joembedded/open_sensor_blue_public/documentation/0800_marder/README.md

# 0800_Marderli #
_Docu for this project_

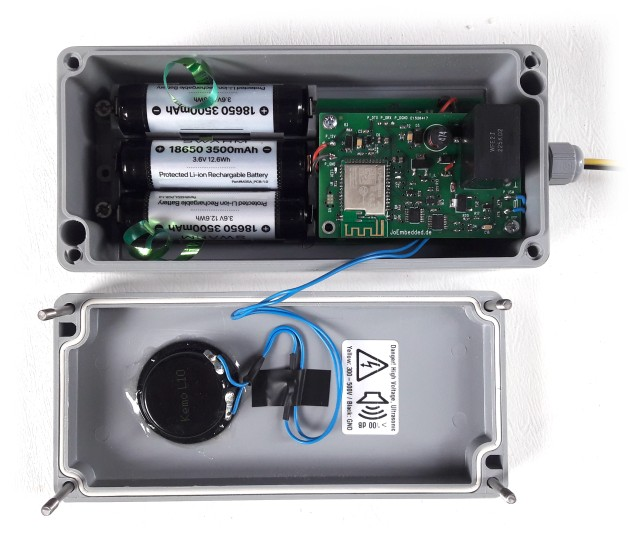
[picture p2: documentation/0800_marder/img/marderli_int.jpg]
'Marderli intern'
 <br>Marderli inside (Battery Version)

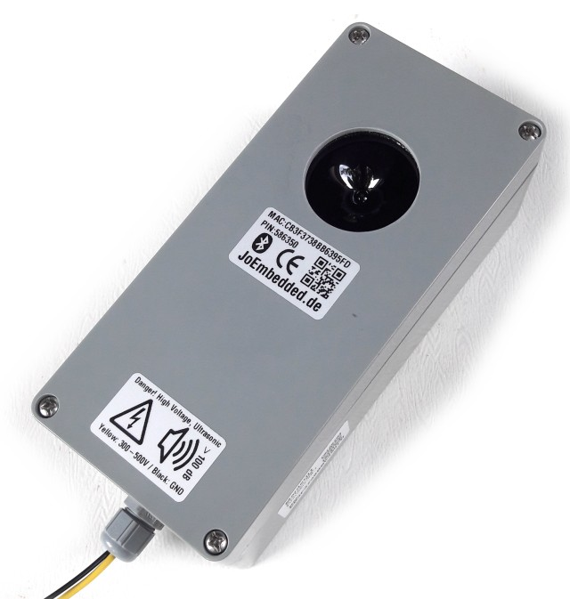
[picture p3: documentation/0800_marder/img/marderli.jpg]
'Marderli'
 <br>Marderli (Battery Version)

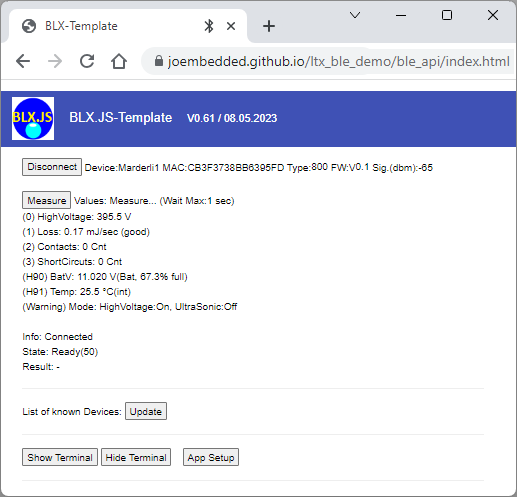
[picture p4: documentation/img_allg/blx_js.png]
Browser-APP 'BLX.JS'
 <br>Browser-APP - Repository: https://github.com/joembedded/ltx_ble_demo

- [Schematics and PCB](./cad/) Production data
- [Simulation](./simulation/) Simulation files for LTspice
- [Images](./img/) More images and measurments

---
