joembedded/open_sensor_blue_public/documentation/0800_marder/img/BLE_Basic_connected.png

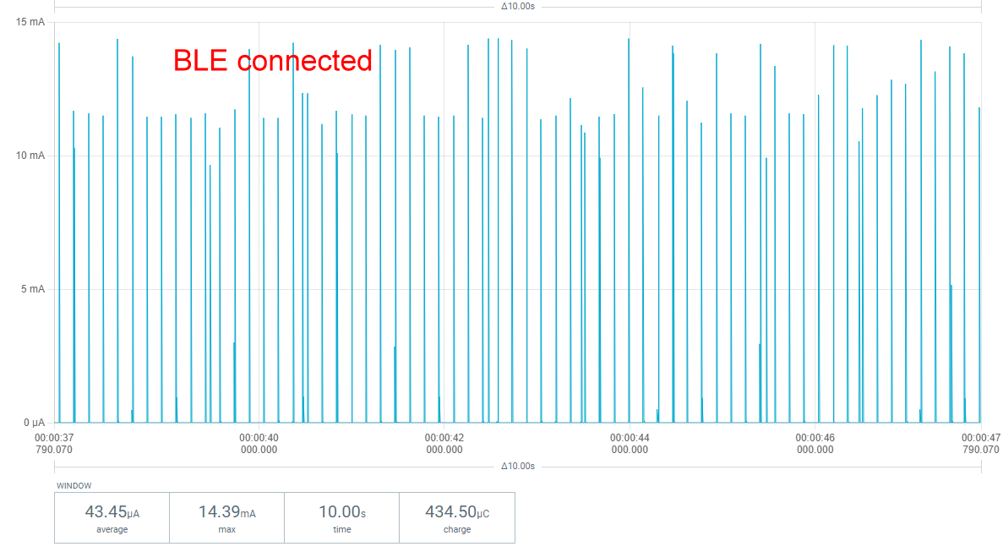
documentation/0800_marder/img/BLE_Basic_connected.png
