joembedded/open_sensor_blue_public/documentation/0800_marder/img/BLE_Basic_unconnected.png

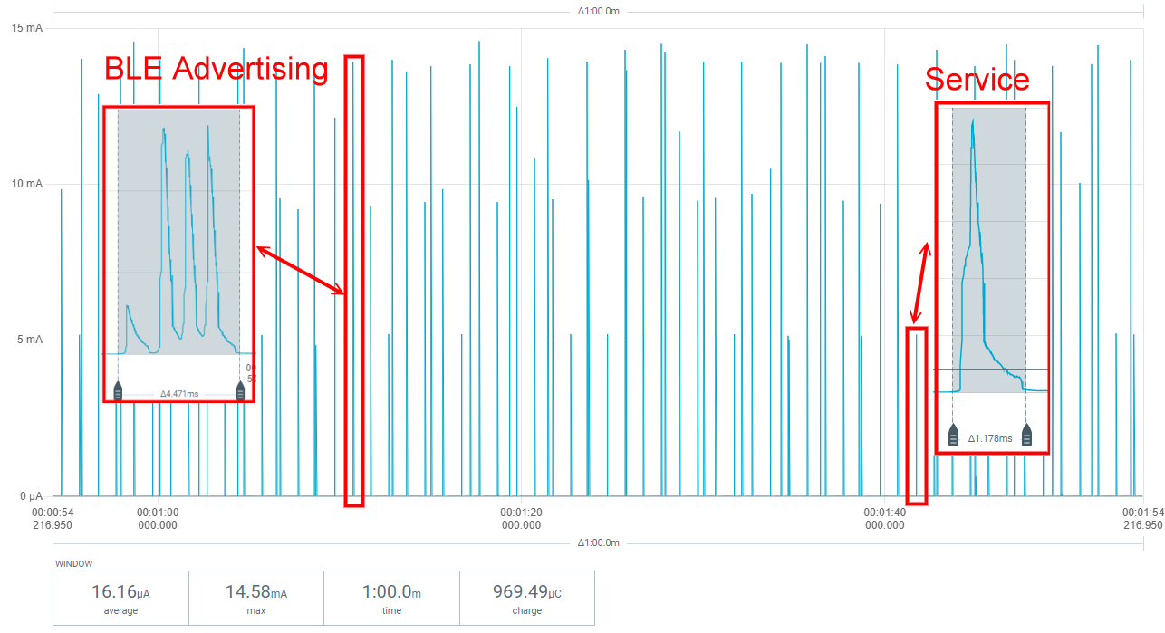
documentation/0800_marder/img/BLE_Basic_unconnected.png
