joembedded/open_sensor_blue_public/documentation/0800_marder/img/charge1k7_real.png

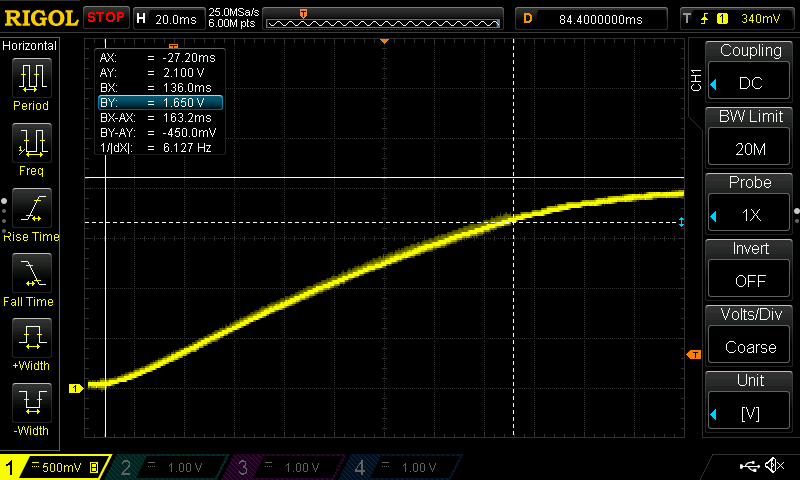
documentation/0800_marder/img/charge1k7_real.png
