joembedded/open_sensor_blue_public/documentation/0800_marder/img/fullcharge_4Ohm7_I_12v_2u2.png

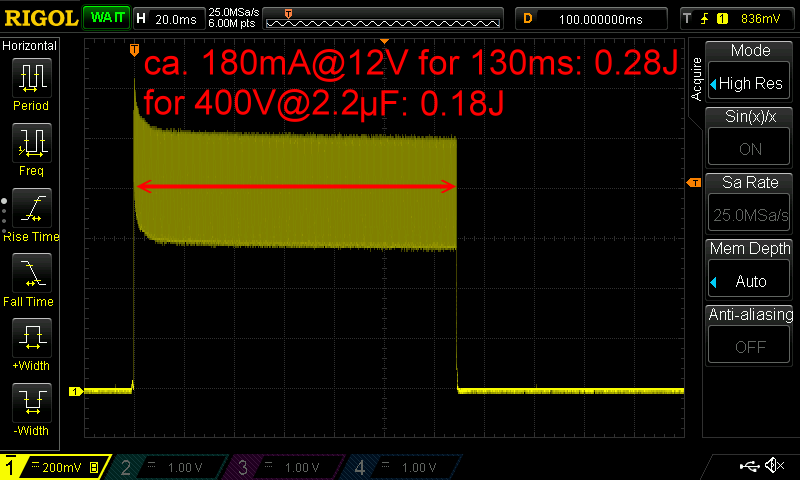
documentation/0800_marder/img/fullcharge_4Ohm7_I_12v_2u2.png
