joembedded/open_sensor_blue_public/documentation/0800_marder/img/pcb_raw.jpg

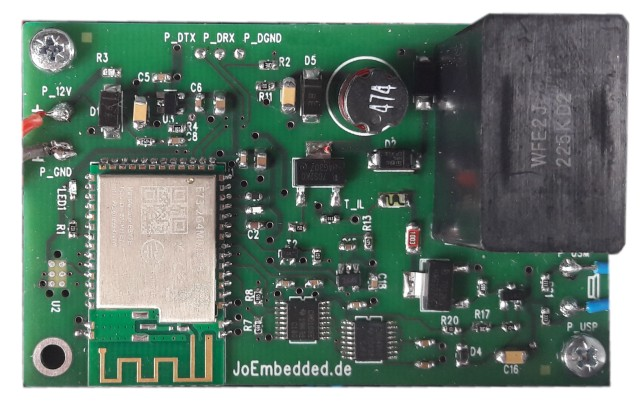
documentation/0800_marder/img/pcb_raw.jpg
