joembedded/open_sensor_blue_public/documentation/0800_marder/img/service_charge_12V_2u2_t210.png

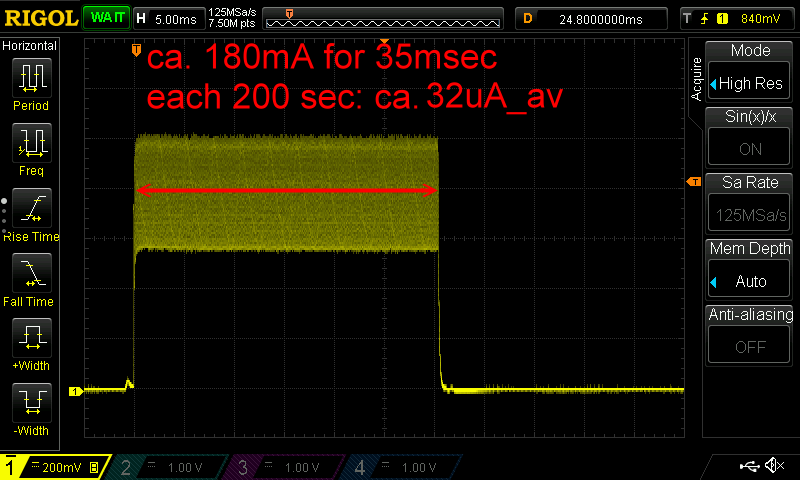
documentation/0800_marder/img/service_charge_12V_2u2_t210.png
