joembedded/open_sensor_blue_public/documentation/0800_marder/img/usonic_4Ohm7_I.png

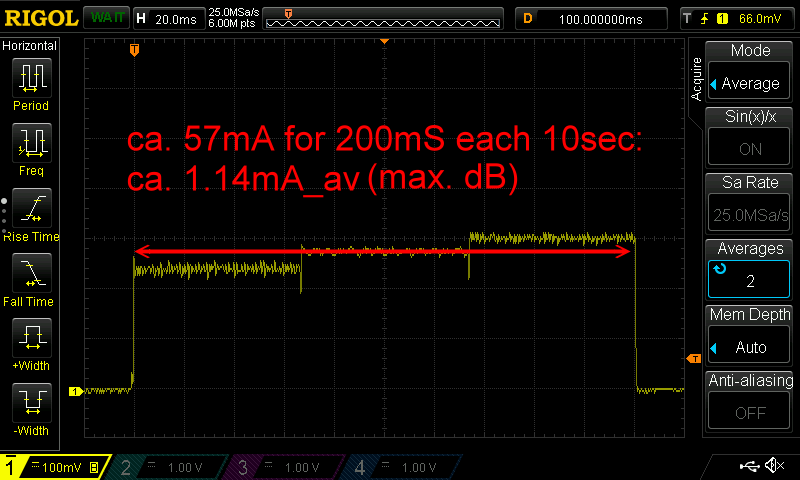
documentation/0800_marder/img/usonic_4Ohm7_I.png
