joembedded/open_sensor_blue_public/documentation/0800_marder/cad/bom_1V1.ods

*** BOM – Marder1V1 – 15.07.2023 – JoEmbedded.de ***
Qty | Reference | Part Name | VALUE | PCB DECAL | Remark | Source (FA: Farnell) | Variant
1 | U1 | E73_BLE |  | E73_BLE | LowCost BLE-Module NRF52832 | CDEBYTE (China)
1 | U3 | XC6216_MR | XC6216, XC6216B332MR oder 331(1 = 1%), 3.3V/SOT23-5 | SOT23-5 |  | FA:3106590
1 | U4 | CD4049 | Inverter/Driver | TSSOP16 |  | MOUSER:595-CD4049UBPWR
1 | U5 | CD40109 | Level-Shifter | TSSOP16 |  | FA:3120904
1 | U6 | TLV_LowIq/Ibias | Opamp TLV379, TLV9041, MCP6041, etc | SOT23-5 |  | FA:1332129 | MPC604
1 | T1,T3 | FET_N-Channel | HV_FET | SOT223-3 | HV_FET, z.B. STN6N60M2 oder IPN70R2K0P7S | FA:3155115
1 | T2 | FET_N-Channel | BSS138W | SC-70-3
1 | T4 | TRANS_UNI_PNP | BC857 | SOT23
2 | D1,D5 | DIODE_TVS | TVS12V – SMAJ12A | SMA | Achtung: nur bis max. 14V einsetzbar, siehe Doku. | FA:2429071
1 | D2 | DIODE | FAST_HV | SMA | HV.Diode Utrafast, >=600V, <=25nsec (z.B. STTH1R06(25 nsec/600V) | FA:1697520
1 | D3 | DIODE_TVS | TVS400V – SMAJ400A | SMA | Durchbruch i.d.R ca. 480V | FA:2763008
1 | D4 | DIODE | 1N4148 in 0805 | DIODE0805 | 1N4148 (SOD-523 aufloetbar auf 0805) | FA:2453270
1 | LED1 | LED_2PINS | ROT | LED0603
3 | C1,C13,C16 | Capacitor(Ceramic) | 22uF/25V | 1206
1 | C2 | Capacitor(Ceramic) | 1uF | 0603
1 | C3,C7 | Capacitor(Ceramic) | 10uF | 0805
8 | C4,C5,C6,C8,C10,C11,C12,C18 | Capacitor(Ceramic) | 100nF | 0603
2 | C9,C17 | Capacitor(Ceramic) | x00nF/25V | 0603 | z.B. fuer KEMO L010: 1uF/25V mit >= 15Ohm in Serie
1 | C14 | Capacitor(Ceramic) | 2.2-4.7uF/600V | C_RM5MMAA | Empfohlen: 2,2uF/600V | FA:2581162 | 2.2uF
1 | C15 | Capacitor(Ceramic) | 10nF | 0603
1 | R1 | Resistor | 1k | 0603
1 | R2 | Resistor | 1M | 0603
1 | R3 | Resistor | 15(*) | 0603 | Falls Vbat >14V mgl, erhoehen oder staerkere Leistung! Siehe Doku.
5 | R4,R7,R8,R16,R17 | Resistor | 1.6M_1% | 0603
2 | R5;R13 | Resistor | 4.7M_1% | 0603
2 | R6,R21 | Resistor | 33k | 0603
1 | R9 | Resistor | 10k | 0603
1 | R10 | Resistor | 15 | 0603
1 | R11 | Resistor | 10(*) | 0603 | Falls Vbat >14 mgl, erhoehen oder staerkere Leistung!
1 | R12 | Resistor | 1GOhm_HV_1% | 1206 | Unbedingt HV-Fester Typ! | FA: 3596701
1 | R14 | Resistor | 100-1k_PP | 1206 | Unbedingt HV-Fester Typ! Limit. Imax, <10k mit 1206 nicht mgl., THT verw.! (im Redesign), z.B. (KTR18, 910Ohm zu schwach)
1 | R15 | Resistor | 100k_HV | 1206 | Unbedingt HV-Fester Typ! | FA:2470926
1 | R18 | Resistor | 0.1 | 0603 | Nur wg. Development,/L3-Test kann 0 sein für Produktion
1 | R19 | Resistor | 160k | 0603
1 | R20 | Resistor | 100 | 0603
1 | L1 | INDUKT | 10uH | 0603 | (nur weil E73 kein DC/DC on Boarrd)
1 | L2 | INDUKT | 15nH | 0603 | (nur weil E73 kein DC/DC on Boarrd)
1 | L3 | INDUKT_PWR | 470uH_HV (>=600V, 1A I_Sat) | IND_RM5MM_D10MM | HV-feste Spulen meist nur in THT erhaehltlich. | Coilcraft:RFC0807BV-474KE
1 | (extern) | USONIC | Ultraschall-Piezo-Lautsprecher mind. >26kHz | KEMO L010 (z.B.) | Achtung: für den KEMO L010: C9,C17 zur Lautstärkebenzung mind. >= 15Ohm in Serie! | KEMO L010
