joembedded/open_sensor_blue_public/documentation/0800_marder/cad/marder_1v1_asstop.pdf

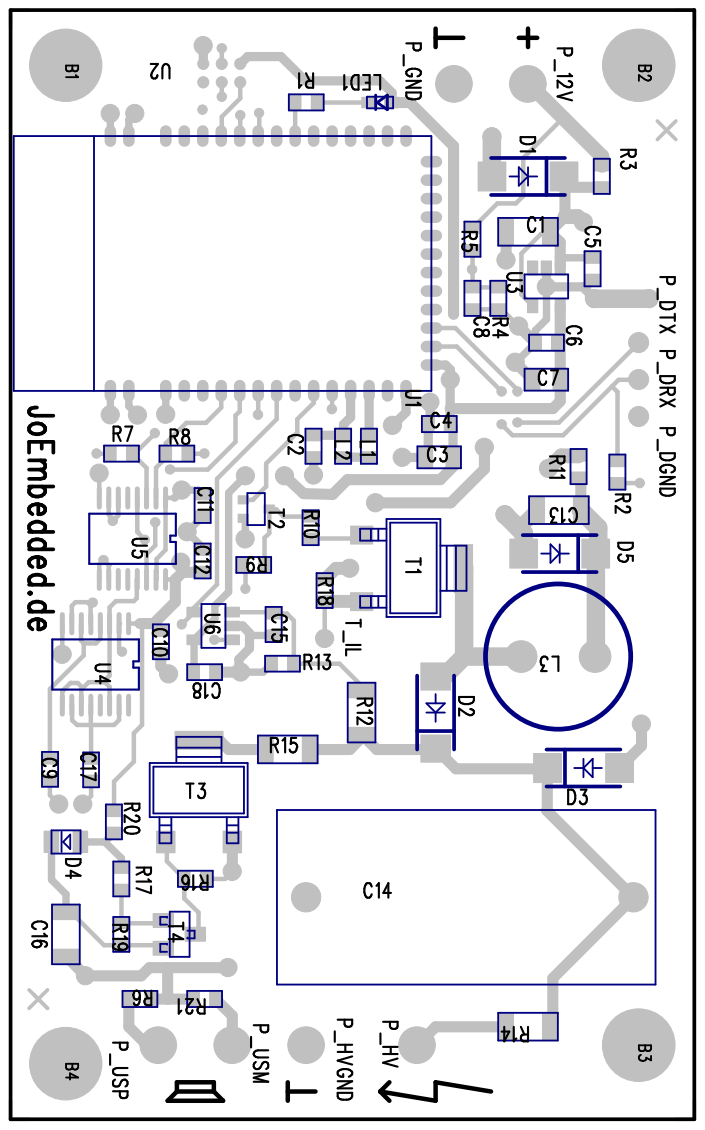
[picture p15: page 1]
