joembedded/open_sensor_blue_public/documentation/0800_marder/cad/marder_1v1_sch.pdf

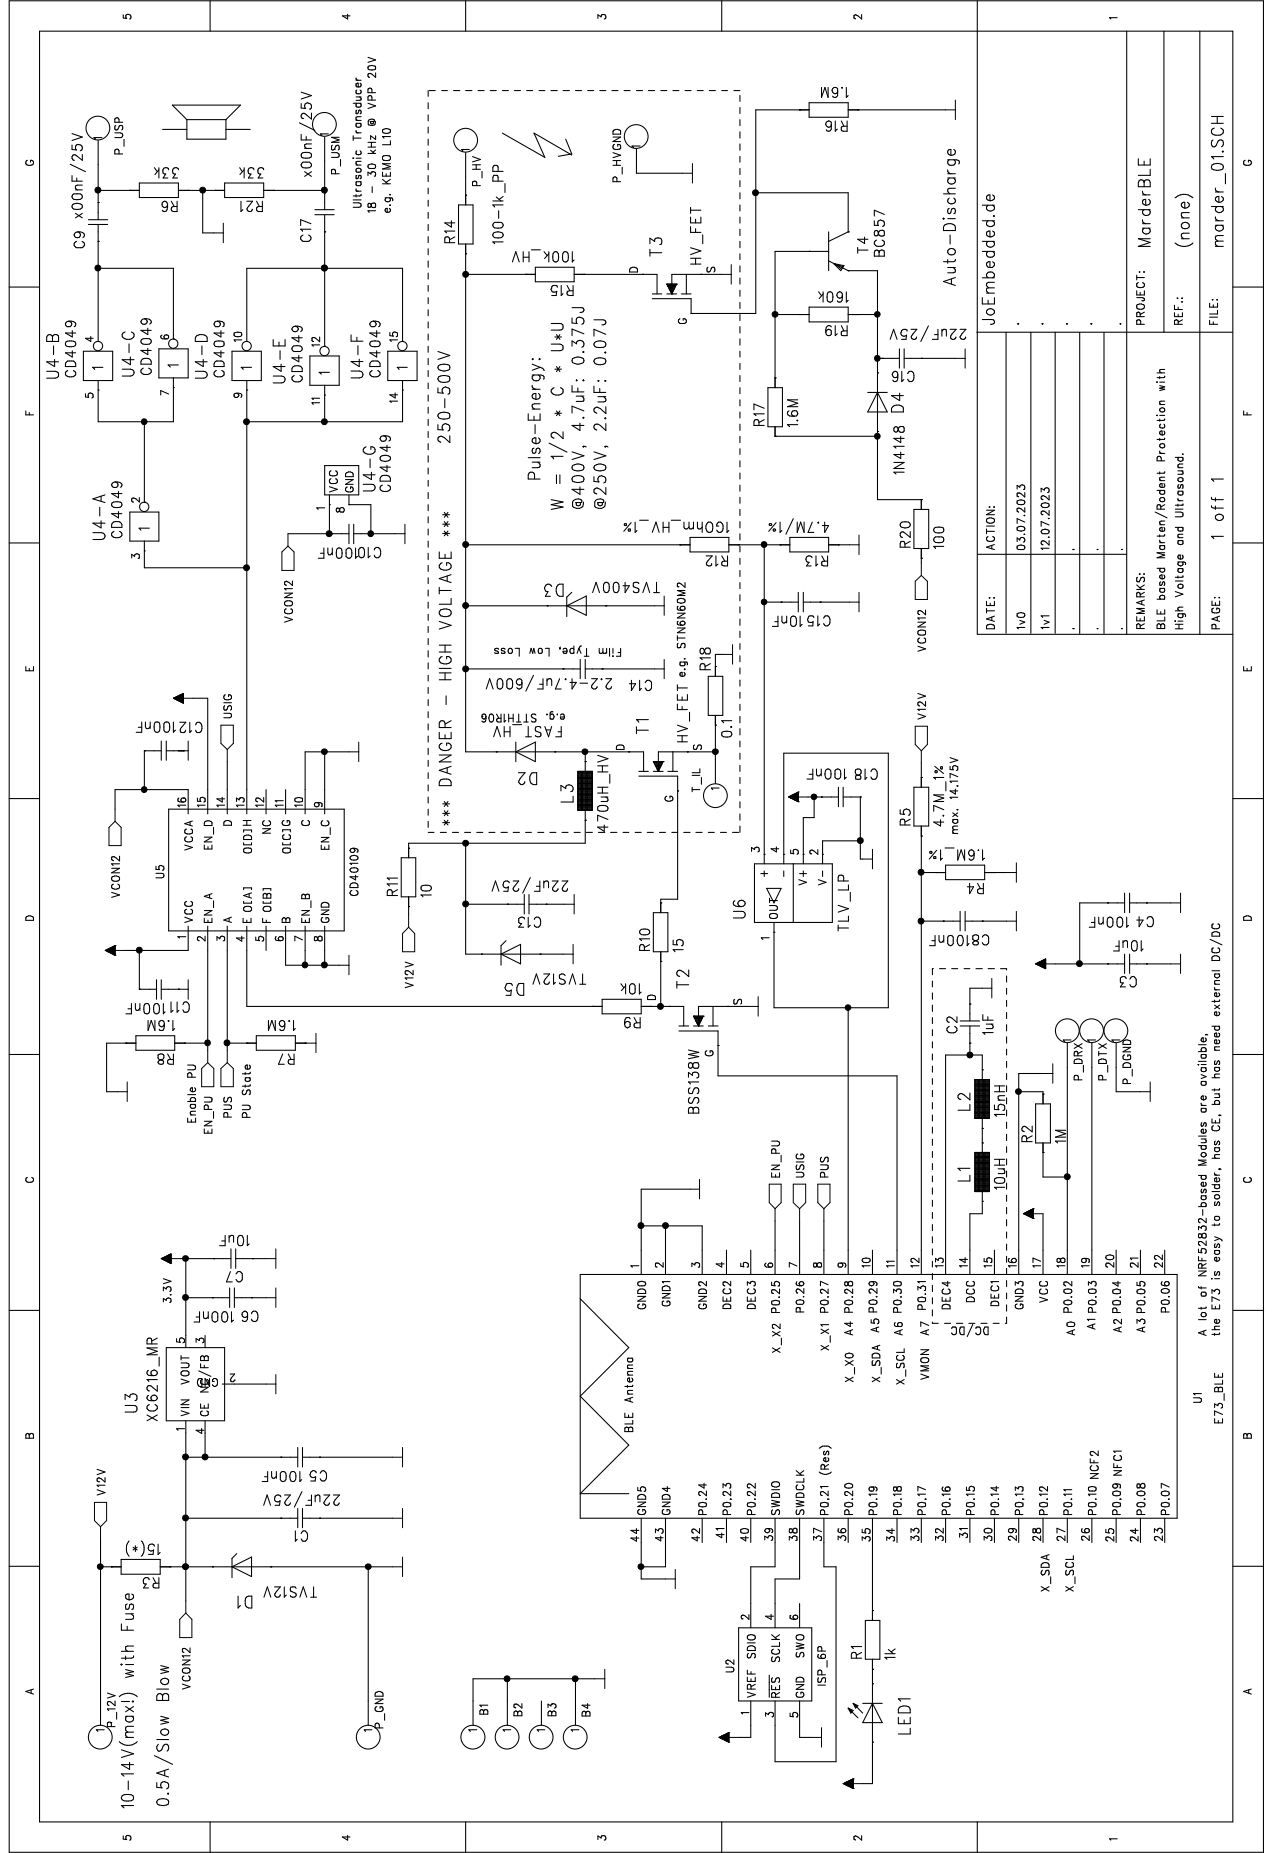
[picture p16: page 1]
