joembedded/open_sensor_blue_public/documentation/0800_marder/simulation/ref_delay.asc

C1: cap; 10n
R1: res; 1000Meg
R2: res; 4.7Meg
V1: voltage; PULSE(0 440 1 1u 0 1)
Named nets: 0, HVolt, Ref
.tran 5
Delay HVolt => Ref ca. 
200 msec auf 99%
100 msec auf 90%
