joembedded/open_sensor_blue_public/documentation/0800_marder/simulation/shutdown.asc

C1: cap; 22µ
D1: diode; 1N4148
Q1: pnp; BC858B
R1: res; 1.6Meg
R2: res; 160k
R3: res; 1.6Meg
R4: res; 100
V1: voltage; PULSE(0 12 1 0 10 1); Rser=100
Named nets: 0, VRES, V12V
.tran 15
Shutdown ca. 6V
