joembedded/open_sensor_blue_public/documentation/0800_marder/simulation/stepper1.asc

C3: cap; 22µ
C4: cap; 2.2µ; V=1000 Rser=5
C5: cap; 10n
D1: diode; RFN1L6S
L1: ind; 470µ; Rser=2
M1: nmos; STP8NM60
R1: res; 0.1
R2: res; 10
R3: res; 15
R4: res; 1000Meg
R5: res; 4.7Meg
V1: voltage; PULSE(0 10 10m 2u 0 38u 96u 1700)
V2: voltage; 12
Named nets: 0, HV, FB, TPI
.tran 240m
FB RC-tau ca:
90%: 100msec
99%: 200msec
TPI: TestPoint I_L
