joembedded/open_sensor_blue_public/Projekt_OpenSensorBlue/cpu_nrf52832/ses/osx_pins.h

/***************************************************************************************************************
* osx_pins.h - Pin definitins for my used HW platforms (similar to tb_pins_nrf52.h)
*
* (C) joembedded.de
***************************************************************************************************************/


//-------- NRF52840-CPUS -------------
#ifdef NINA_B3_EVK
#endif

#if defined(NINA_B3_LTX) || defined(NINA_B3_EPA)
#endif

//-------- NRF52832-CPUS -------------
#ifdef ANNA_SDI12 // ANNA-SDI12 Sensor platform with ANNA-B112
	#define SDI_RX_PIN  NRF_GPIO_PIN_MAP(0, 4) // SDI12: SDI_RX (needs ext. PULUP)
	#define SDI_TX_PIN  NRF_GPIO_PIN_MAP(0, 5) 
#endif

#ifdef YJ_NRF52832  // YJ_16048 from HolyIot (NO CE/FCC uncertified Low-Cost module)
	#define SDI_RX_PIN  NRF_GPIO_PIN_MAP(0, 6) // YJ_NRF52832 - SDI12: SDI_RX (has ext. PULUP)
	#define SDI_TX_PIN  NRF_GPIO_PIN_MAP(0, 7) 
#endif

#define IX_SCL  NRF_GPIO_PIN_MAP(0, 30) 
#define IX_SDA  NRF_GPIO_PIN_MAP(0, 29) 
#define BUS0_SCL  IX_SCL  // Wenn I2C_BUS0_100KHZ_DIV def. wird ext. BUS0 anders behandelt
#define BUS0_SDA  IX_SDA

#define IX_X0  NRF_GPIO_PIN_MAP(0, 28) // opt. A4
#define IX_X1  NRF_GPIO_PIN_MAP(0, 27) 
#define IX_X2  NRF_GPIO_PIN_MAP(0, 25) 

//***
