joembedded/open_sensor_blue_public/jw_libs/poly16.h

/****************************************************
* poly16.h
*
* (C) joembedded@gmail.com - joembedded.de
*
***************************************************/

uint16_t poly16_track_crc16(uint8_t *pdata, uint16_t wlen, uint16_t crc_run);

//**
